grantbreaksthings/piboy/README.md

PiBoy SP

This board is designed to fit inside of a GBA SP Shell and work in tandem with a SPI LCD Screen and Raspberry Pi Zero to create a portable game console.
https://www.grant.com/piboy-sp
