grantbreaksthings/piboy/Asset 1.png

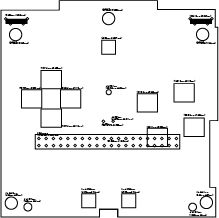
Asset 1.png
