grantbreaksthings/piboy/gbasp.png

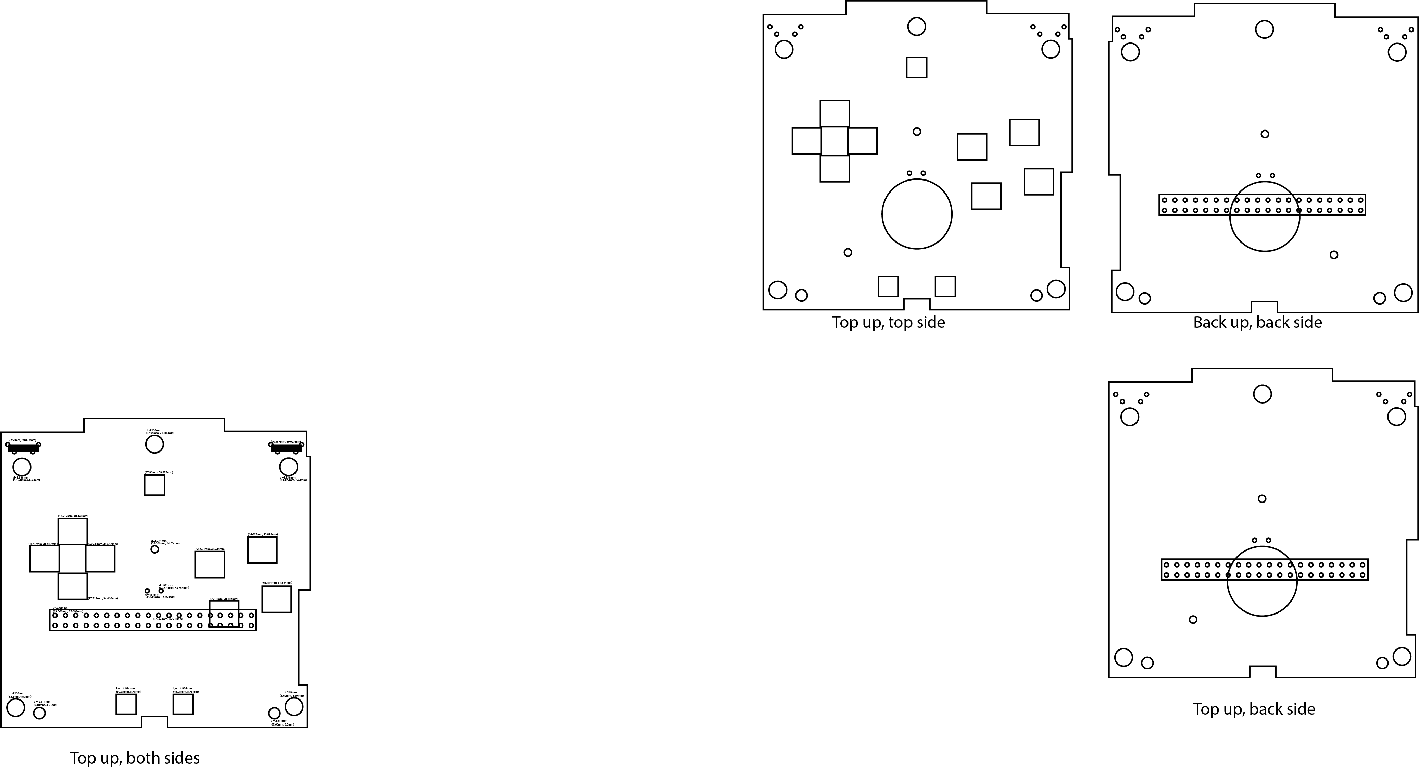
gbasp.png
