grantbreaksthings/piboy/Rasp_Zero_Footprint.png

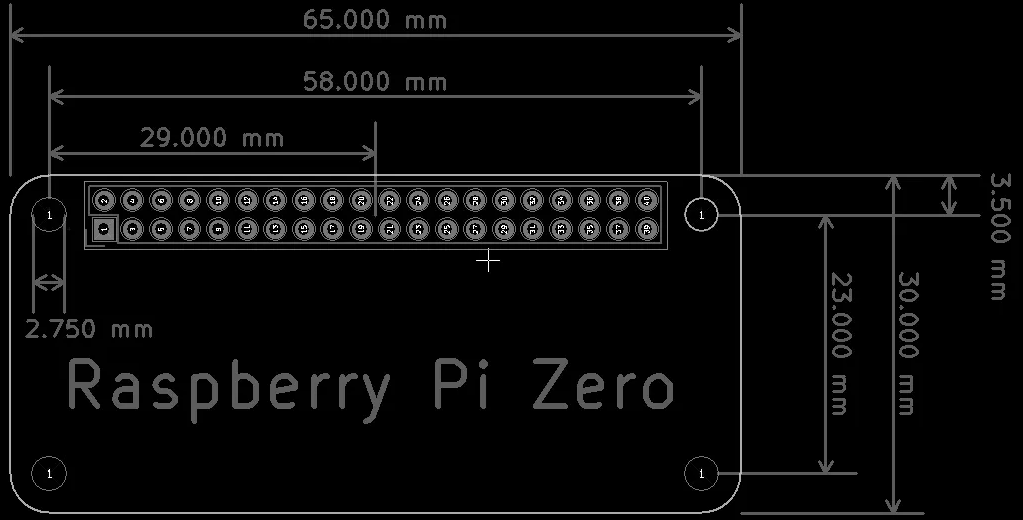
Rasp_Zero_Footprint.png
