grantbreaksthings/piboy/Raspberry-Pi-Zero-Dimensions-Footprint.jpg

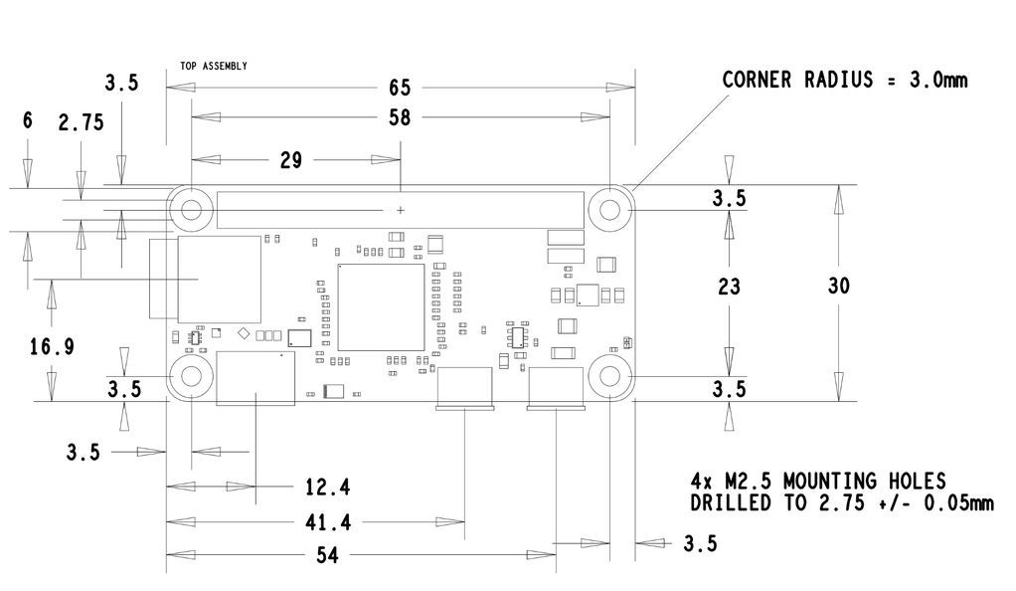
Raspberry-Pi-Zero-Dimensions-Footprint.jpg
