grantbreaksthings/piboy/gbasp.dxf

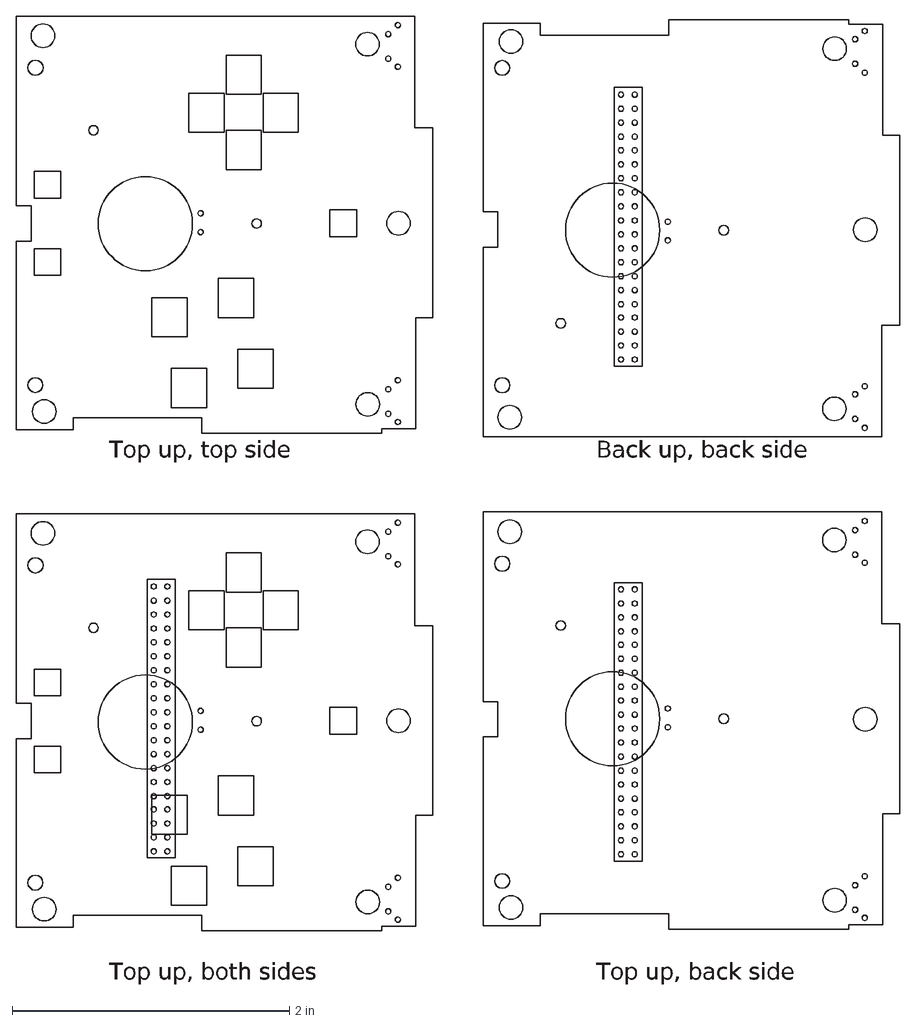
[picture p5: CAD file, 2022-05-11]
gbasp.dxf
Top up, both sides
Top up, top side
Back up, back side
Top up, back side
