grantbreaksthings/piboy/(list of files, cad)

Other CAD files:
gbasp.dwg
