grantbreaksthings/piboy/piboy.pdf

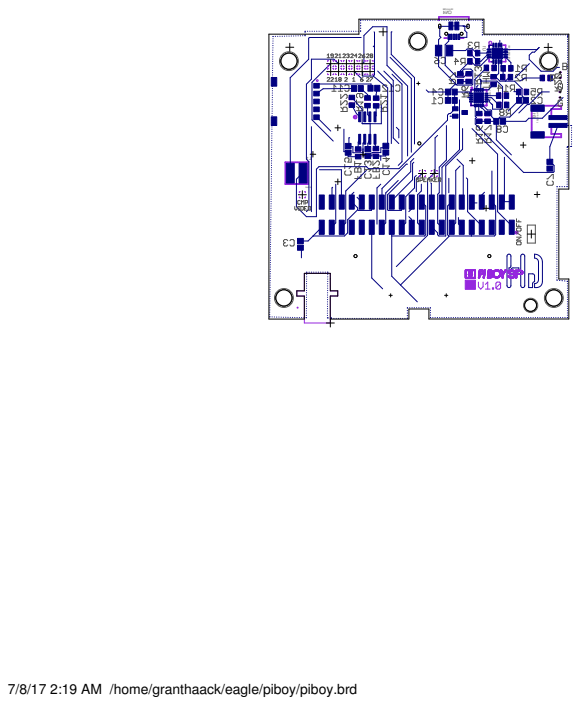
[picture p6: page 1]

7/8/17 2:19 AM /home/granthaack/eagle/piboy/piboy.brd
