grantbreaksthings/piboy/piboy.brd

## EAGLE design piboy.brd (2022-05-11)

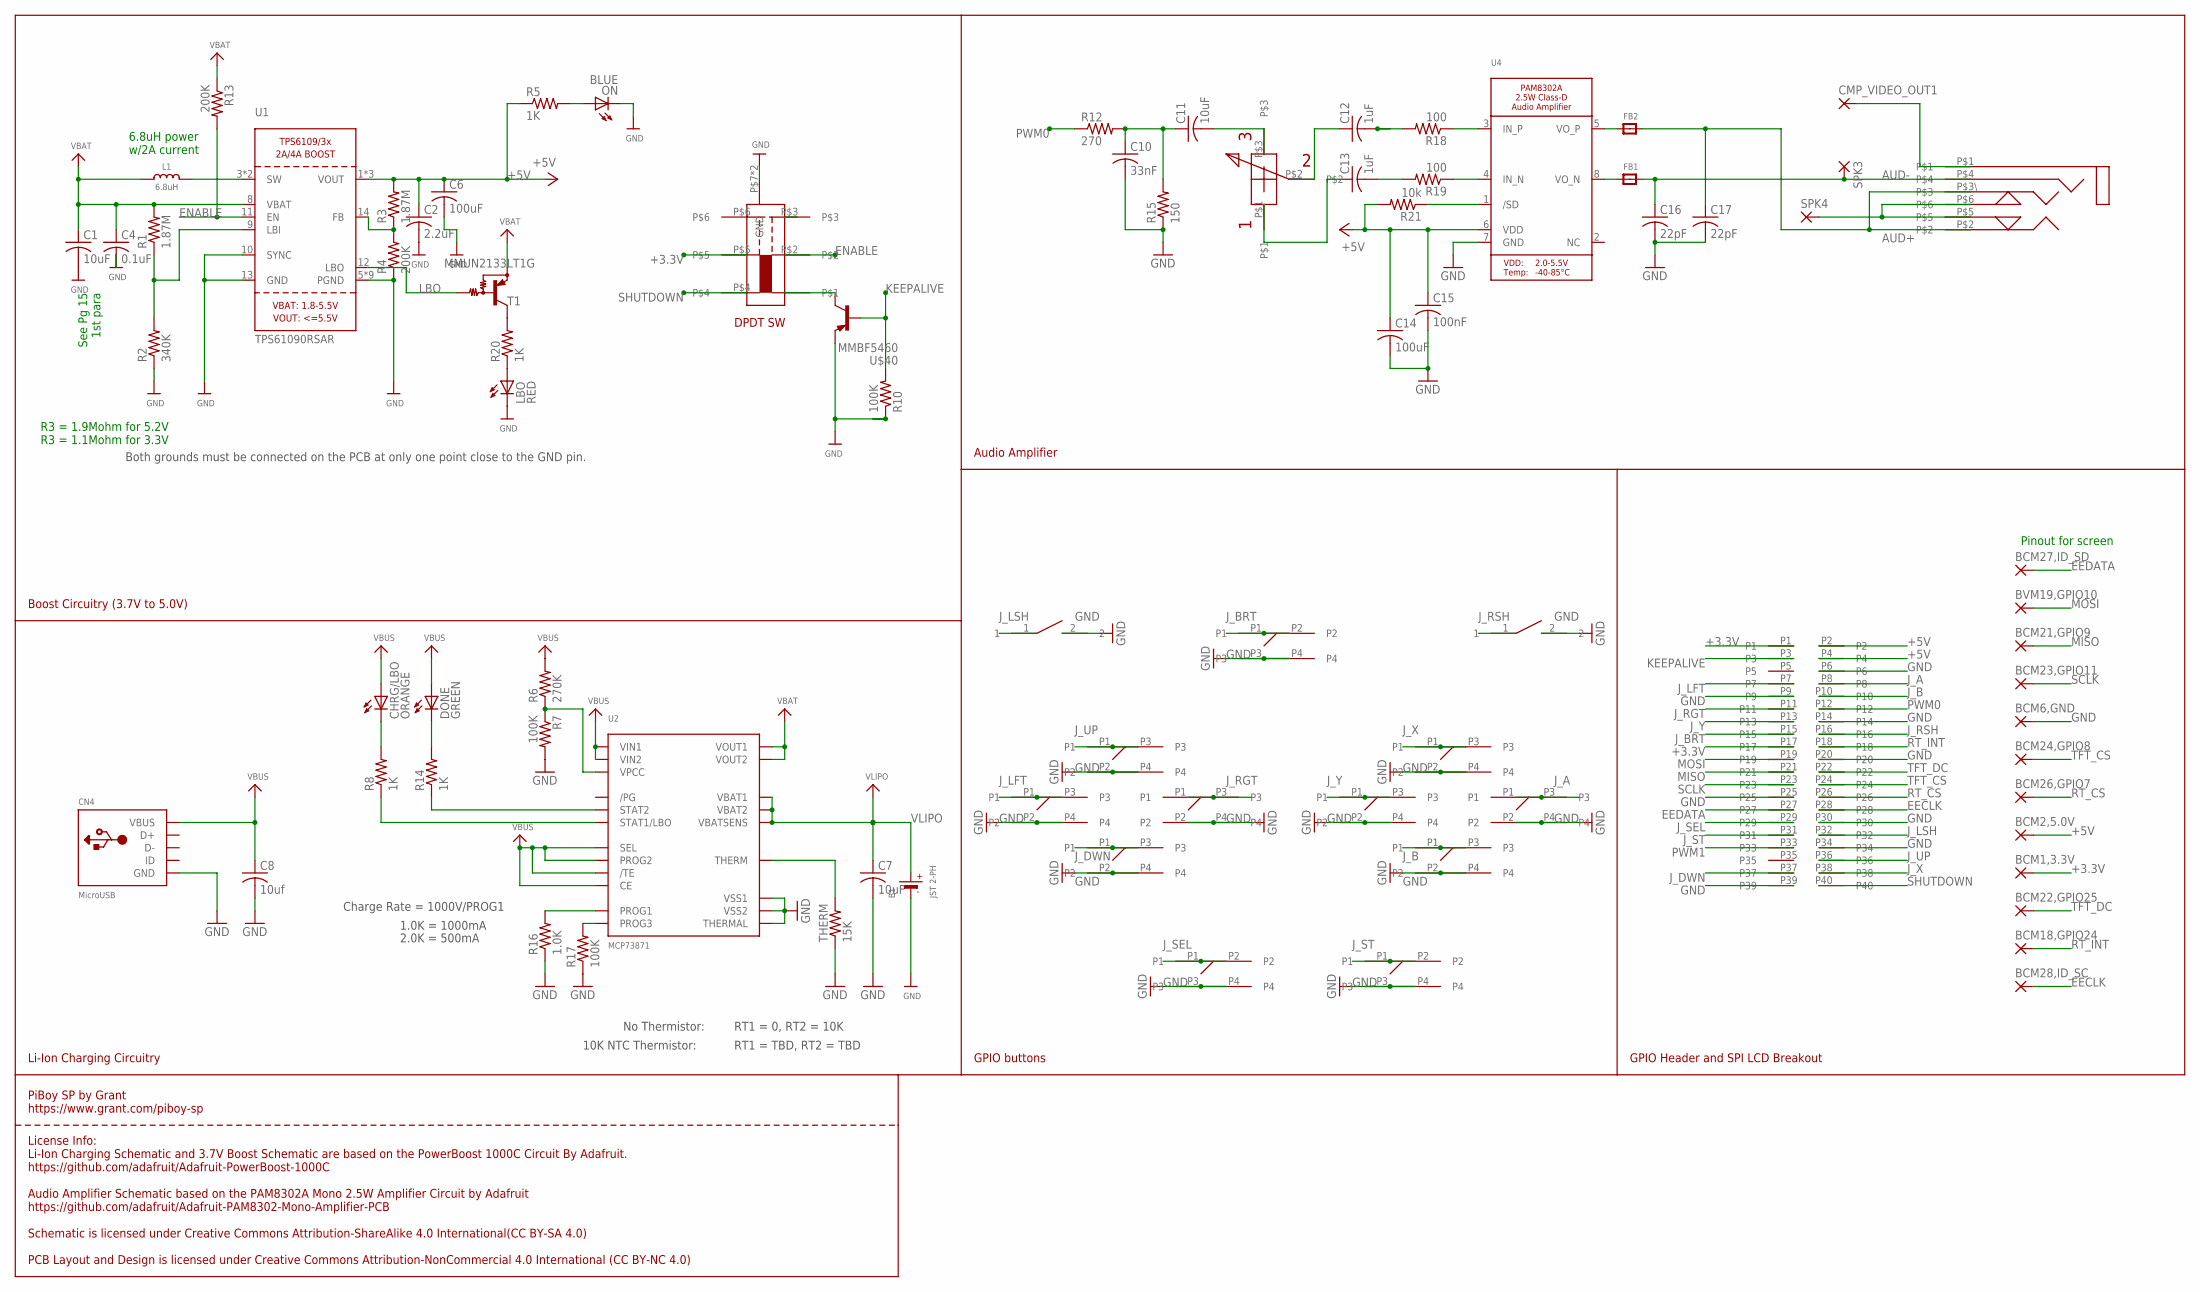
[picture p7: schematic piboy.sch]

Parts:
B1: JST 2-PH; MICROBUILDER_JSTPH2_NOTHERMALS
BCM1,3.3V, BCM2,5.0V, BCM6,GND, BCM18,GPIO24, BCM21,GPIO9, BCM22,GPIO25, BCM23,GPIO11, BCM24,GPIO8, BCM26,GPIO7, BCM27,ID_SD, BCM28,ID_SC: WIREPAD_1,6/0,9
BVM19,GPIO10: WIREPAD_1,6/0,9
C1, C7, C11: 10uF; C1210
C2: 2.2uF; C0805
C4: 0.1uF; C0805
C6, C14: 100uF; C1210
C8: 10uf; C0805
C10: 33nF; C0805
C12, C13: 1uF; C0805
C15: 100nF; C0805
C16, C17: 22pF; C0805
CHRG/LBO: ORANGE; ADAFRUIT_CHIPLED_0603
CMP_VIDEO_OUT1: WIREPAD_1,6/0,9
CN4: MicroUSB; 4UCONN_20329
DONE: GREEN; ADAFRUIT_CHIPLED_0603
FB1, FB2: FERRITE0805; 0805
L1: 6.8uH; INDUCTOR_5X5MM_TDK_VLC5045
LBO: RED; ADAFRUIT_CHIPLED_0603
ON: BLUE; ADAFRUIT_CHIPLED_0603
R1, R3: 1.87M; R0805
R2: 340K; R0805
R4, R13: 200K; R0805
R5, R8, R14, R20: 1K; R0805
R6: 270K; R0805
R7, R10, R17: 100K; R0805
R12: 270; R0805
R15: 150; R0805
R16: 1.0K; R0805
R18, R19: 100; R0805
R21: 10k; R0805
SPK3, SPK4: WIREPAD_1,6/0,9
T1: MMUN2133LT1G; TRANSISTOR_SC59-BEC
THERM: 15K; R0805
U1: TPS61090RSAR; PVQFN-16
U2: MCP73871; QFN20_4MM
U4: AUDIOAMP_PAM8302A; MSOP8_0.65MM
U$9: 961240-6300-AR-PR
U$10, U$11, U$12, U$13, U$15, U$16, U$17, U$18: PIBOY_SKRRAAE010
U$21, U$22, U$25: PIBOY_TL3315NF100Q
U$26, U$28: SWITCH_TL1105L-4,3
U$29: RK10J12R0A0B
U$30: SJ-43504-SMT-TR
U$31: EG2210-SW
U$40: MMBF5460; SOT23

Connections:
+3.3V: BCM1,3.3V.1, U$9.P1, U$9.P17, U$31.P$5
+5V: BCM2,5.0V.1, C2.1, C6.1, C14.1, C15.1, R3.2, R5.1, R21.2, U1.1 (VOUT), U1.15 (VOUT), U1.16 (VOUT), U4.6 (VDD), U$9.P2, U$9.P4
AUD+: C17.1, FB2.2, U$30.P$2, U$30.P$3\
AUD+_HDPN_OUT: SPK4.1, U$30.P$5, U$30.P$6
AUD-: C16.1, FB1.2, SPK3.1, U$30.P$4
CMP_VIDEO_OUT1: CMP_VIDEO_OUT1.1, U$30.P$1
EECLK: BCM28,ID_SC.1, U$9.P28
EEDATA: BCM27,ID_SD.1, U$9.P27
ENABLE: R13.2, U1.11 (EN), U$31.P$2
GND: B1.1 (-), B1.NC1 (-), B1.NC2 (-), BCM6,GND.1, C1.2, C2.2, C4.2, C6.2, C7.2, C8.2, C10.2, C14.2, C15.2, C16.2, C17.2, CN4.BASE@1 (GND), CN4.BASE@2 (GND), CN4.GND, CN4.SPRT@1 (GND), CN4.SPRT@2 (GND), CN4.SPRT@3 (GND), CN4.SPRT@4 (GND), LBO.C, ON.C, R2.1, R4.1, R7.2, R10.1, R15.1, R16.1, R17.1, THERM.1, U1.5 (PGND), U1.6 (PGND), U1.7 (PGND), U1.10 (SYNC), U1.13 (GND), U1.P$18 (PGND), U1.P$19 (PGND), U1.P$20 (PGND), U1.P$21 (PGND), U1.P$22 (PGND), U1.THERMAL (PGND), U2.P$10 (VSS1), U2.P$11 (VSS2), U2.P$21 (THERMAL), U4.7 (GND), U$9.P6, U$9.P9, U$9.P14, U$9.P20, U$9.P25, U$9.P30, U$9.P34, U$9.P39, U$10.P2, U$10.P4, U$11.P2, U$11.P4, U$12.P2, U$12.P4, U$13.P2, U$13.P4, U$15.P2, U$15.P4, U$16.P2, U$16.P4, U$17.P2, U$17.P4, U$18.P2, U$18.P4, U$21.P3, U$21.P4, U$22.P3, U$22.P4, U$25.P3, U$25.P4, U$26.2, U$28.2, U$31.P$7 (GND), U$31.P$8 (GND), U$40.2 (S)
J_A: U$9.P8, U$17.P1, U$17.P3
J_B: U$9.P10, U$18.P1, U$18.P3
J_BRT: U$9.P15, U$25.P1, U$25.P2
J_DWN: U$9.P37, U$13.P1, U$13.P3
J_LFT: U$9.P7, U$11.P1, U$11.P3
J_LSH: U$9.P32, U$26.1
J_RGT: U$9.P11, U$12.P1, U$12.P3
J_RSH: U$9.P16, U$28.1
J_SEL: U$9.P29, U$21.P1, U$21.P2
J_ST: U$9.P31, U$22.P1, U$22.P2
J_UP: U$9.P36, U$10.P1, U$10.P3
J_X: U$9.P38, U$15.P1, U$15.P3
J_Y: U$9.P13, U$16.P1, U$16.P3
KEEPALIVE: R10.2, U$9.P3, U$40.3 (G)
LBO: T1.B, U1.12 (LBO)
MISO: BCM21,GPIO9.1, U$9.P21
MOSI: BVM19,GPIO10.1, U$9.P19
unnamed: L1.P$2 (2), U1.3 (SW), U1.4 (SW)
unnamed: LBO.A, R20.1
unnamed: R1.1, R2.2, U1.9 (LBI)
unnamed: ON.A, R5.2
unnamed: R3.1, R4.2, U1.14 (FB)
unnamed: R20.2, T1.C
unnamed: R6.1, R7.1, U2.P$2 (VPCC)
unnamed: DONE.C, R14.2
unnamed: R14.1, U2.P$7 (STAT2)
unnamed: THERM.2, U2.P$5 (THERM)
unnamed: R8.1, U2.P$8 (STAT1/LBO)
unnamed: CHRG/LBO.C, R8.2
unnamed: R17.2, U2.P$12 (PROG3)
unnamed: R16.2, U2.P$13 (PROG1)
unnamed: C10.1, C11.1, R12.2, R15.2
unnamed: U$31.P$1, U$40.1 (D)
unnamed: C11.2, U$29.P$3
unnamed: C12.1, U$29.P$2
unnamed: C13.1, U$29.P$1
unnamed: C13.2, R19.2
unnamed: C12.2, R18.2
unnamed: R18.1, U4.3 (IN_P)
unnamed: R19.1, U4.4 (IN_N)
unnamed: R21.1, U4.1 (/SD)
unnamed: FB1.1, U4.8 (VO_N)
unnamed: FB2.1, U4.5 (VO_P)
PWM0: R12.1, U$9.P12
PWM1: U$9.P33
RT_CS: BCM26,GPIO7.1, U$9.P26
RT_INT: BCM18,GPIO24.1, U$9.P18
SCLK: BCM23,GPIO11.1, U$9.P23
SHUTDOWN: U$9.P40, U$31.P$4
TFT_CS: BCM24,GPIO8.1, U$9.P24
TFT_DC: BCM22,GPIO25.1, U$9.P22
VBAT: C1.1, C4.1, L1.P$1 (1), R1.2, R13.1, T1.E, U1.8 (VBAT), U2.P$1 (VOUT1), U2.P$20 (VOUT2)
VBUS: C8.1, CHRG/LBO.A, CN4.VBUS, DONE.A, R6.2, U2.P$3 (SEL), U2.P$4 (PROG2), U2.P$9 (/TE), U2.P$17 (CE), U2.P$18 (VIN1), U2.P$19 (VIN2)
VLIPO: B1.2 (+), C7.1, U2.P$14 (VBAT1), U2.P$15 (VBAT2), U2.P$16 (VBATSENS)

Notes on the sheet:
Both grounds must be connected on the PCB at only one point close to the GND pin.
See Pg 15 1st para
6.8uH power w/2A current
R3 = 1.9Mohm for 5.2V R3 = 1.1Mohm for 3.3V
Charge Rate = 1000V/PROG1
1.0K = 1000mA
2.0K = 500mA
No Thermistor:
10K NTC Thermistor:
RT1 = 0, RT2 = 10K
RT1 = TBD, RT2 = TBD
Pinout for screen
GPIO Header and SPI LCD Breakout
GPIO buttons
Boost Circuitry (3.7V to 5.0V)
Li-Ion Charging Circuitry
Audio Amplifier
License Info: Li-Ion Charging Schematic and 3.7V Boost Schematic are based on the PowerBoost 1000C Circuit By Adafruit. https://github.com/adafruit/Adafruit-PowerBoost-1000C Audio Amplifier Schematic based on the PAM8302A Mono 2.5W Amplifier Circuit by Adafruit https://github.com/adafruit/Adafruit-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
PiBoy SP by Grant https://www.grant.com/piboy-sp

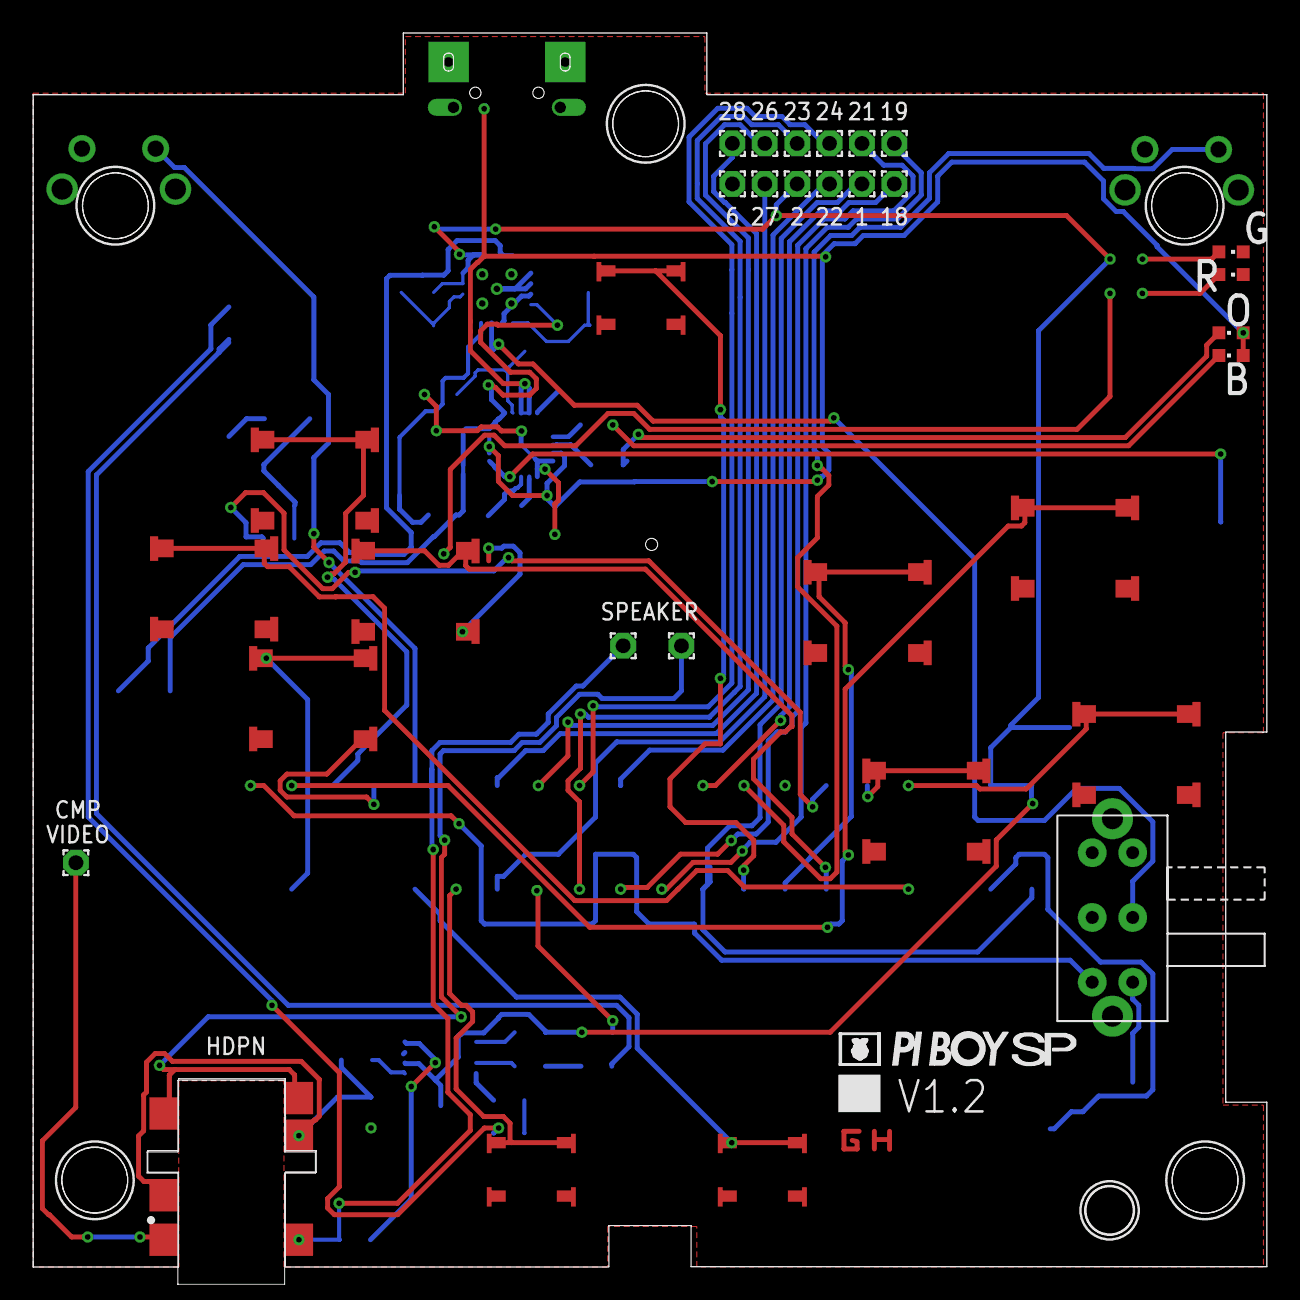
[picture p8: board piboy.brd from above]

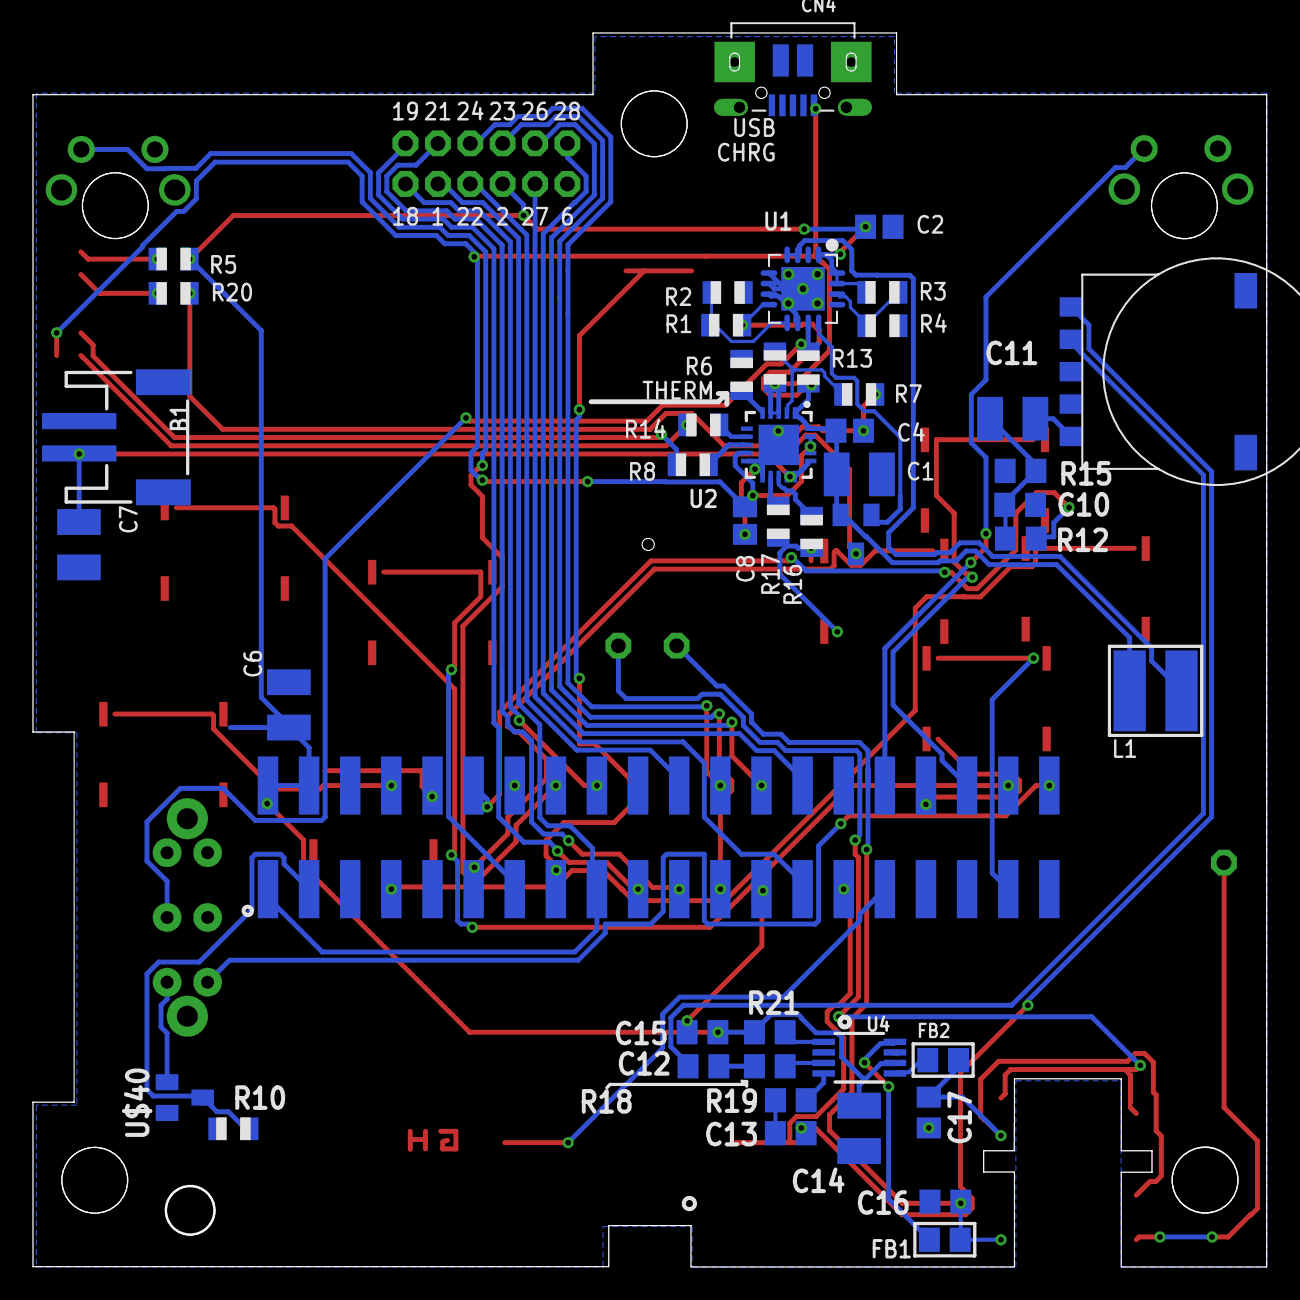
[picture p9: board piboy.brd from below]

Board: 2 copper layers, 76.2 x 76.2 mm, 80 parts (46 on the bottom side), 63 nets.
