grantbreaksthings/piboy/(notices)

Notices in the files:
piboy.brd:
PCB Layout and Design is licensed under
Creative Commons
Attribution-NonCommercial 4.0
International (CC BY-NC 4.0)
piboy.sch:
Schematic is licensed under Creative Commons Attribution-ShareAlike 4.0 International(CC BY-SA 4.0)
PCB Layout and Design is licensed under Creative Commons Attribution-NonCommercial 4.0 International (CC BY-NC 4.0)
parts and their libraries:
microbuilder: This work is placed in the public domain, and may be freely used for commercial and non-commercial work with the following conditions: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
